MythosMann/macropolo/README.md

# macropolo
Macro Polo
My little macro pad using kailh choc switches with support for 2 rotary encoders.  I swear it's not a ripoff of the bdn9, don't hurt me.
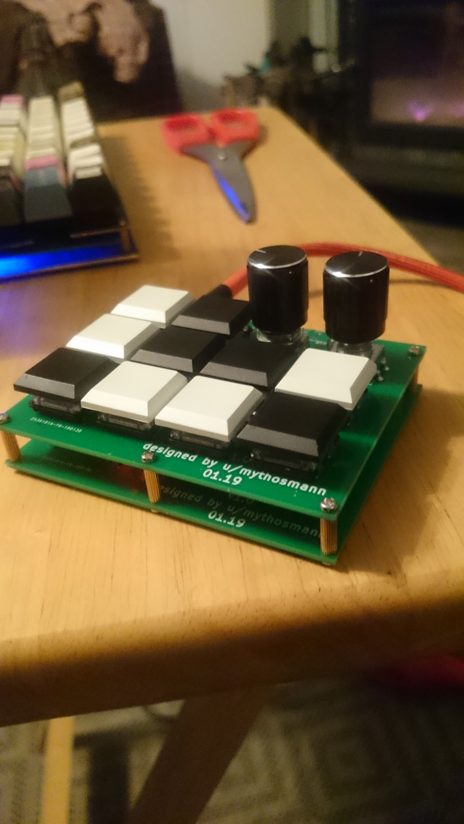
[picture p1: DSC_1881.JPG]
