MythosMann/macropolo/DSC_1882.JPG

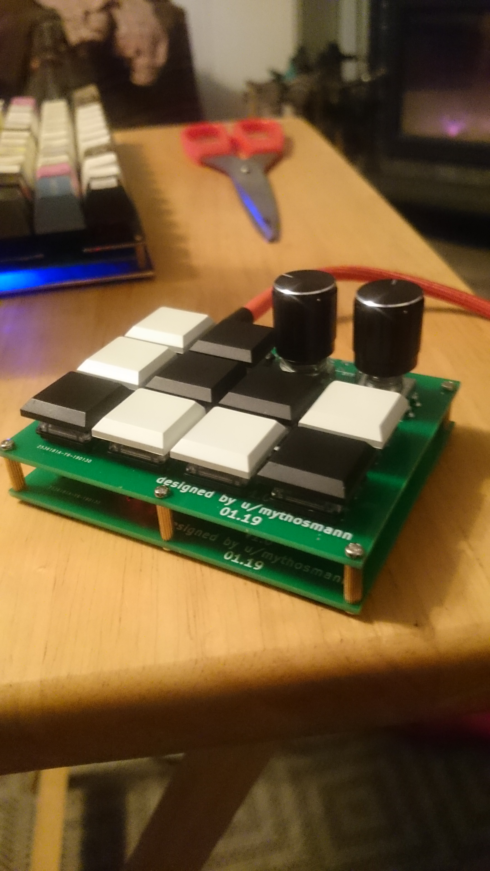
DSC_1882.JPG
