MythosMann/macropolo/kicad/BOM.xlsx

Designator | Manufacturer Part Number or Seeed SKU | Qty | Link
D6, D9, D10, D11, D12, D13, D14, D15, D16, D17, D18, D19 | 1N4148W-7-F | 12 | https://www.diodes.com/assets/Datasheets/ds30086.pdf
C1 | GRM188R61A105KA61D | 1 | http://file.elecfans.com/web1/M00/57/12/pIYBAFtEZLaADptHAA0At2QEA7w030.pdf
C2, C3 | GCM1885C1H220JA16D | 2 | http://psearch.en.murata.com/capacitor/product/GCM1885C1H220JA16%23.pdf
R1, R2 | RC0603FR-0710KL | 2 | http://www.yageo.com.tw/exep/pages/download/literatures/PYu-R_INT-thick_7.pdf
U1 | ATMEGA32U4-MU | 1 | http://www.atmel.com/Images/Atmel-7766-8-bit-AVR-ATmega16U4-32U4_Summary.pdf
Y1 | TXM16.000M2503LDCE-O00T | 1 | http://file.elecfans.com/web1/M00/81/C4/o4YBAFw4QU6AEHeAAAMGQaAmFW8248.pdf
