MythosMann/macropolo/(commit log)

2019-01-25 Added low_profile branch
    [4x5macro.sch]
2019-01-25 Initialized KiCad files
    [4x5macro.kicad_pcb, 4x5macro.sch]
2019-01-25 Update 4x5macro.kicad_pcb
    changed footprints to Daprice's choc hotswap
    [4x5macro.kicad_pcb]
2019-01-25 started updating traces for choc switches
    [4x5macro.kicad_pcb]
2019-01-25 done more work updating the footprints
    [4x5macro.kicad_pcb]
2019-01-27 updated rot_encoders to switches
    [4x5macro.kicad_pcb, 4x5macro.sch]
2019-01-27 updated a trace, gerber files
    [4x5macro-B.Cu.gbr, 4x5macro-B.Mask.gbr, 4x5macro-B.Paste.gbr, 4x5macro-B.SilkS.gbr, 4x5macro-Edge.Cuts.gbr, 4x5macro-F.Cu.gbr, 4x5macro-F.Mask.gbr, 4x5macro-F.Paste.gbr]
2019-01-27 gerber files
    [4x5macro-B.Cu.gbr, 4x5macro-B.Mask.gbr, 4x5macro-B.Paste.gbr, 4x5macro-B.SilkS.gbr, 4x5macro-Edge.Cuts.gbr, 4x5macro-F.Cu.gbr, 4x5macro-F.Mask.gbr, 4x5macro-F.Paste.gbr]
2019-01-27 fixed mounting holes
    [4x5macro-B.Cu.gbr, 4x5macro-B.Mask.gbr, 4x5macro-B.Paste.gbr, 4x5macro-B.SilkS.gbr, 4x5macro-Edge.Cuts.gbr, 4x5macro-F.Cu.gbr, 4x5macro-F.Mask.gbr, 4x5macro-F.Paste.gbr]
2019-01-30 small updates
    [4x5macro-B.Cu.gbr, 4x5macro-B.Mask.gbr, 4x5macro-B.Paste.gbr, 4x5macro-B.SilkS.gbr, 4x5macro-Edge.Cuts.gbr, 4x5macro-F.Cu.gbr, 4x5macro-F.Mask.gbr, 4x5macro-F.Paste.gbr]
2019-01-30 gerbers and graphics update
    [4x5macro-B.Cu.gbr, 4x5macro-B.Mask.gbr, 4x5macro-B.Paste.gbr, 4x5macro-B.SilkS.gbr, 4x5macro-Edge.Cuts.gbr, 4x5macro-F.Cu.gbr, 4x5macro-F.Mask.gbr, 4x5macro-F.Paste.gbr]
2019-02-02 working on case
2019-02-02 added sandwich case dxf files
    [macro_bottom.dxf, macro_middle.dxf, macro_switch.dxf]
2019-02-10 Fixed LED Polarity
    [4x5macro.kicad_pcb, 4x5macro.sch]
2019-02-12 started organizing tracks
    [4x5macro.kicad_pcb]
2019-02-24 updated gerbers
    [4x5macro-B.Cu.gbr, 4x5macro-B.Mask.gbr, 4x5macro-B.Paste.gbr, 4x5macro-B.SilkS.gbr, 4x5macro-Edge.Cuts.gbr, 4x5macro-F.Cu.gbr, 4x5macro-F.Mask.gbr, 4x5macro-F.Paste.gbr]
2019-02-25 updated pcb
    [4x5macro-B.Cu.gbr, 4x5macro-B.Mask.gbr, 4x5macro-B.Paste.gbr, 4x5macro-B.SilkS.gbr, 4x5macro-Edge.Cuts.gbr, 4x5macro-F.Cu.gbr, 4x5macro-F.Mask.gbr, 4x5macro-F.Paste.gbr]
2019-02-25 cleaned repo
    [4x5macro-B.Cu.gbr, 4x5macro-B.Mask.gbr, 4x5macro-B.Paste.gbr, 4x5macro-B.SilkS.gbr, 4x5macro-Edge.Cuts.gbr, 4x5macro-F.Cu.gbr, 4x5macro-F.Mask.gbr, 4x5macro-F.Paste.gbr]
2019-02-25 rev 1.1 release
    [4x5macro-B.Cu.gbr, 4x5macro-B.Mask.gbr, 4x5macro-B.Paste.gbr, 4x5macro-B.SilkS.gbr, 4x5macro-Edge.Cuts.gbr, 4x5macro-F.Cu.gbr, 4x5macro-F.Mask.gbr, 4x5macro-F.Paste.gbr]
2019-02-25 organized, released rev1.1
    [4x5macro-B.Cu.gbr, 4x5macro-B.Mask.gbr, 4x5macro-B.Paste.gbr, 4x5macro-B.SilkS.gbr, 4x5macro-Edge.Cuts.gbr, 4x5macro-F.Cu.gbr, 4x5macro-F.Mask.gbr, 4x5macro-F.Paste.gbr]
2019-02-26 removed junk files
    [4x5macro-B.Cu.gbr, 4x5macro-B.Mask.gbr, 4x5macro-B.Paste.gbr, 4x5macro-B.SilkS.gbr, 4x5macro-Edge.Cuts.gbr, 4x5macro-F.Cu.gbr, 4x5macro-F.Mask.gbr, 4x5macro-F.Paste.gbr]
2019-03-06 plate file
    [plate.kicad_pcb]
2019-03-06 moved files
    [4x5macro.kicad_pcb, 4x5macro.sch, plate.kicad_pcb]
2019-03-06 low profile files
    [4x5macro.kicad_pcb, 4x5macro.sch, plate.kicad_pcb]
2019-03-06 created switch footprint
    [4x5macro.kicad_pcb, 4x5macro.sch]
2019-03-06 removed redundant files
    [4x5macro.kicad_pcb, 4x5macro.sch, plate.kicad_pcb]
2019-03-06 started from scratch
    [4x5macro.kicad_pcb, 4x5macro.sch]
2019-04-13 completed schematic
    [4x5macro.kicad_pcb, 4x5macro.sch]
2019-04-25 rev 2.0!
    [4x5macro-B.Cu.gbr, 4x5macro-B.Mask.gbr, 4x5macro-B.Paste.gbr, 4x5macro-B.SilkS.gbr, 4x5macro-Edge.Cuts.gbr, 4x5macro-F.Cu.gbr, 4x5macro-F.Mask.gbr, 4x5macro-F.Paste.gbr]
